AlexGyver/MeteoClock/schemes/scheme3.jpg

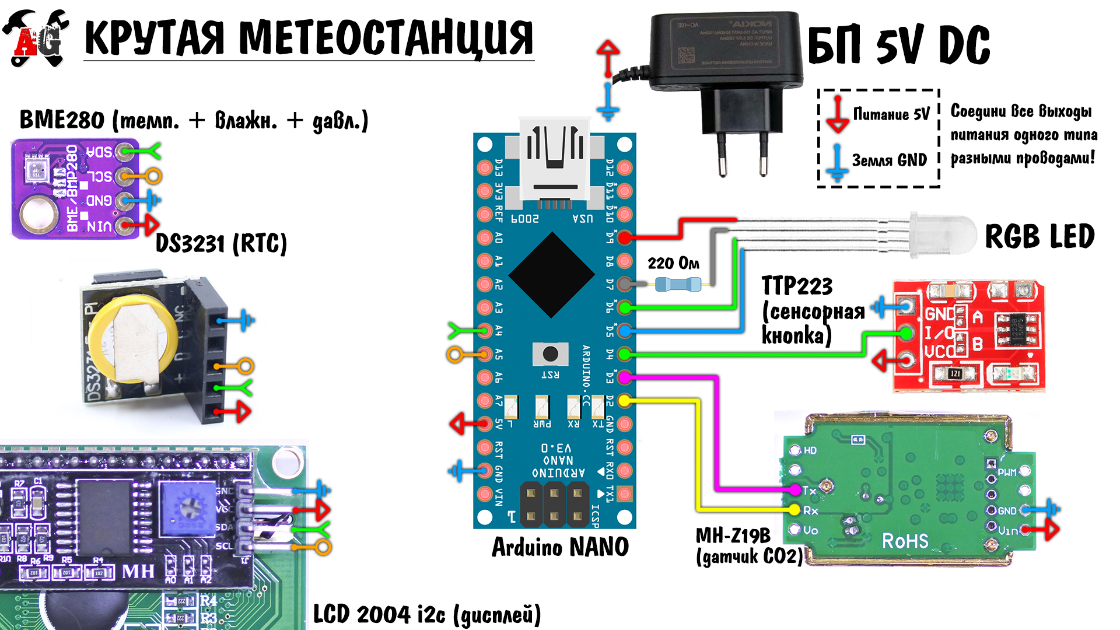
schemes/scheme3.jpg
