AlexGyver/MeteoClock/(threads)

Thread 4 (2019-04-08):

Доработка под работу на аккумуляторе

nick7zmail, 2019-04-08:
Можно доработать прошивку для работы с аккумулятором?
т.е. выключения дисплея (диод можно оставить включенным) по таймеру, периодическое "просыпание" и замеры показателей, пробуждение по кнопке.

Thread 6 (2019-05-30):

Опечатки в комментариях

hellofaduck, 2019-05-30:
Нашел в комментариях пару опечаток:
- Не забудь поправить пределы гроафика
-// если дисплей не заводится - поменяйте адрес (строка 54)
Но теперь адрес дисплея в строке 49!

+пожелание, новичку будет чуть проще если добавить комментарии в разделе "пины", не сразу очевидно например, что такое mhz. не критично конечно, кому надо сообразят за пару минут, но все же :)
